MiKumBa21/Wetterstation/Dokumentation/Administratorhandbuch.docx

HTL-Wels

ITP

Administratorhandbuch

Wetterstation

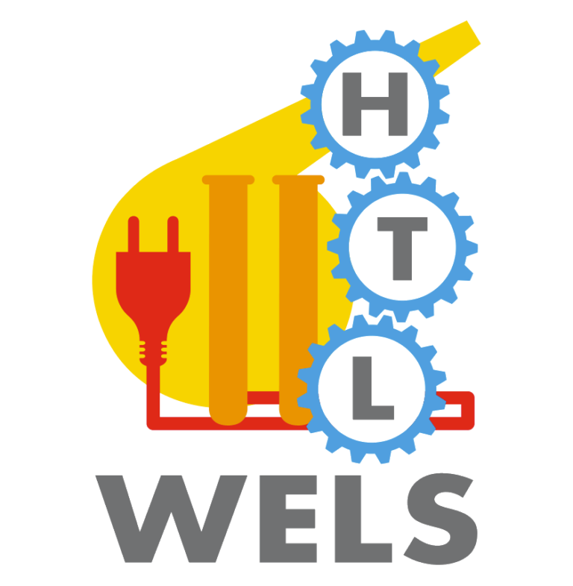
[picture p1: figure]
Höhere technische Bundeslehranstalt Wels

# 1. Ziel des Administratorhandbuchs

Dieses Dokument beschreibt die vollständige Installation, Inbetriebnahme und Erweiterung der Wetterstation.

Die Beschreibung richtet sich vorallem an Personen ohne tiefgehende IT-Kenntnisse. Alle Arbeitsschritte werden deshalb möglichst einfach und verständlich erklärt.

Ziel ist es, dass auch neue Mitarbeiterinnen und Mitarbeiter die Wetterstation selbstständig installieren, starten und bedienen können.

# 2. Benötigte Hardware

Bevor mit dem Aufbau begonnen wird, müssen alle Komponenten vorhanden sein. Die folgende Liste enthält alles, was für einen vollständigen Aufbau der Wetterstation benötigt wird.

## 2.1 Elektronik & Hauptkomponenten

Komponente | Beschreibung | Hinweis
Raspberry Pi Zero 2W | Der Hauptrechner der Wetterstation – verarbeitet alle Sensordaten, speichert sie in der Datenbank und stellt die Website bereit | Unbedingt die Version 2W verwenden (hat WLAN eingebaut)
MicroSD-Karte | Speichermedium für das Betriebssystem und die gesamte Software | Mindestens 16 GB, empfohlen 32 GB
MicroSD-Kartenleser | Wird einmalig zum Aufspielen des Images benötigt | Viele Laptops haben einen eingebauten Leser; sonst USB-Adapter
DHT22 | Sensor für Temperatur (–40 bis +80 °C) und relative Luftfeuchtigkeit (0–100 %) | Oft als Breakout-Board mit 3 Pins erhältlich – das ist die einfachere Variante
VEML7700 | Sensor für Lichtstärke | Als Breakout-Board kaufen (z. B. von Adafruit) – hat bereits die nötigen Widerstände eingebaut
US5881LUA | Hall-Effekt-Sensor; erkennt Magnetfelder und wird im selbstgebauten Anemometer zur Messung der Windgeschwindigkeit verwendet | Kleiner 3-poliger Sensor im TO-92-Gehäuse (sieht aus wie ein kleiner Transistor)
Magnet (Neodym, klein) | Wird im Windrad des Anemometers befestigt und löst beim Vorbeidrehen den Hall-Sensor aus | Muss stark genug sein, um den Hall-Sensor zuverlässig zu aktivieren

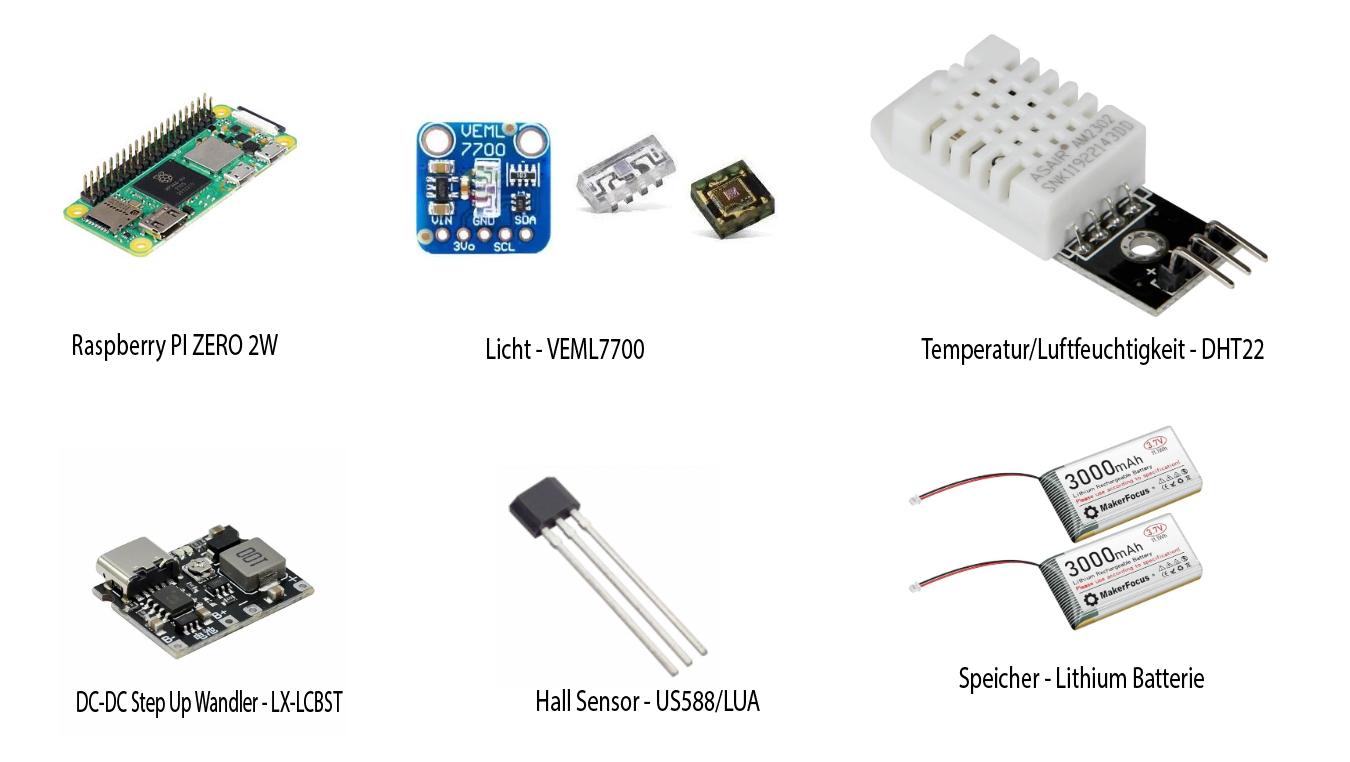
[picture p2: figure]

## 2.2 Stromversorgung

Material | Beschreibung | Hinweis
Akku (LiFePO4) | Versorgt den Raspberry Pi und die Sensoren mit Strom | 3000mAh empfohlen
DC-DC-Wandler | Wandelt die Akkuspannung auf die für den Raspberry Pi benötigte Spannung um | Einstellbar auf 5V; Ausgangsspannung vor dem Anschluss unbedingt messen

## 2.3 Kabel & Verbindungsmaterial

Material | Beschreibung | Hinweis
Jumperkabel | Verbindungskabel zwischen Sensoren und GPIO-Pins des Raspberry Pi | Farben: egal
Lötkolben + Lötzinn | Für feste, dauerhafte Verbindungen der Kabel an die Sensor-Pins | Alternativ: Steckverbinder, aber Löten ist langlebiger für den Außeneinsatz
Schrumpfschlauch | Isoliert gelötete Verbindungen | mit Heißluftfön oder Feuerzeug aufschrumpfen
Kabelbinder | Kabel im Gehäuse ordentlich fixieren | Klein (2,5 mm Breite) reicht aus

## 2.4 Werkzeug

Werkzeug | Wofür
Multimeter | Spannungen messen, Kabelverbindungen prüfen, Kurzschlüsse ausschließen
Seitenschneider / Abisolierer | Kabel kürzen und abisolieren
Kleiner Imbud Schraubendreher | Gehäuse montieren
Heißklebepistole | Sensoren im Gehäuse fixieren (wenn keine Halterungen vorgesehen sind)
3D-Drucker (oder Zugang dazu) | Für das Gehäuse und das Anemometer (siehe Abschnitt 2.5)

## 2.5 Gehäuse & 3D-Druck

Das Gehäuse der Wetterstation sowie das Anemometer (Windrad) wurden eigens für dieses Projekt konstruiert und mit einem 3D-Drucker aus PETG-Filament gedruckt. PETG ist wetter- und UV-beständiger als das häufiger verwendete PLA und daher für den Außeneinsatz besser geeignet.

CAD-Dateien: Die CAD-Dateien für das Gehäuse und das Anemometer befinden sich im GitHub-Repository des Projekts. Sie können mit Tinkercad (kostenlos, browserbasiert, auch für Einsteiger geeignet) oder jedem anderen CAD-Programm geöffnet und angepasst werden.

[Screenshot-Platzhalter: Screenshot der CAD-Dateien im GitHub-Repository]

Gehäuse anpassen – worauf zu achten ist:

Bevor das Gehäuse gedruckt wird, sollte geprüft werden, ob alle Komponenten hineinpassen. Folgende Maße sind relevant:

- Raspberry Pi Zero 2W: 65 × 30 mm Grundfläche, ca. 5 mm hoch (ohne Pins)
- DHT22 (Breakout): ca. 15 × 25 mm
- VEML7700 (Breakout): ca. 19 × 13 mm
- Hall-Sensor: TO-92-Gehäuse, ca. 5 × 5 mm – muss im Anemometer so sitzen, dass der Magnet im Windrad direkt daran vorbeizieht (Abstand: max. 3–5 mm)
- Kabelkanäle und Kabeldurchführungen einplanen
- Lüftungsschlitze für den Raspberry Pi vorsehen – er erzeugt im Betrieb Wärme
- Der DHT22 muss Luftkontakt haben (nicht vollständig einschließen), darf aber nicht direktem Regen ausgesetzt sein → Wetterschutzblende oder seitliche Öffnung

Anemometer:

Das Anemometer besteht aus einem Rotor mit befestigtem Neodym-Magneten und einer fixen Halterung für den Hall-Sensor. Bei jeder vollen Umdrehung des Windrades fährt der Magnet am Hall-Sensor vorbei – das erzeugt einen elektrischen Impuls, der vom Raspberry Pi gezählt wird. Aus der Anzahl der Impulse pro Zeiteinheit wird die Windgeschwindigkeit berechnet.

[Screenshot-Platzhalter: Foto des fertig gedruckten Anemometers mit eingebautem Magneten und Hall-Sensor]

Druckempfehlungen:

Einstellung | Empfehlung
Material | PETG (für Außeneinsatz); kein PLA
Schichthöhe | 0,2 mm
Wandstärke | Mindestens 3 Perimeter (ca. 1,2 mm bei 0,4er Düse)
Füllung (Infill) | 20–30 %
Supports | Abhängig vom Modell
Druckbett-Temperatur | ~70–80 °C (PETG haftet besser mit beheiztem Bett)
Düsentemperatur | ~230–245 °C

Tipp: Vor dem vollständigen Druck immer zuerst einen kleinen Testdruck (z. B. nur eine Ecke des Gehäuses) machen, um die Maße und die Passgenauigkeit zu prüfen. Das spart Filament und Zeit.

# 3. Verkabelung der Sensoren

Wichtig: Den Raspberry Pi immer ausschalten (Strom trennen), bevor Sensoren angeschlossen oder getrennt werden. Niemals Kabel unter Spannung anschließen!

## 3.1 Pinbelegung

Der Raspberry Pi Zero 2W hat einen 40-poligen GPIO-Stecker. Die Pins sind in zwei Reihen angeordnet und von 1 bis 40 nummeriert. Pins, die für mehrere Sensoren benötigt werden, wie zum Beispiel der Ground oder der 3,3V Pin, können über Klemmen auf eins zusammengeführt werden. Für diese Wetterstation werden nur folgende Pins verwendet:

Pin-Nummer | Bezeichnung | Verwendung
Pin 1 | 3,3 V (Stromversorgung) | Strom für alle drei Sensoren
Pin 2 | 5 V (STromversorgung) | Strom vom Akku
Pin 3 | GPIO2 - SDA | Daten (VEML7700)
Pin 5 | GPIO3 - SCL | Takt (VEML7700)
Pin 6 | GND (Masse) | Masse für alle drei Sensoren
Pin 7 | GPIO4 | Datensignal DHT22
Pin 11 | GPIO17 | Datensignal Hall-Sensor (Windgeschwindigkeit)

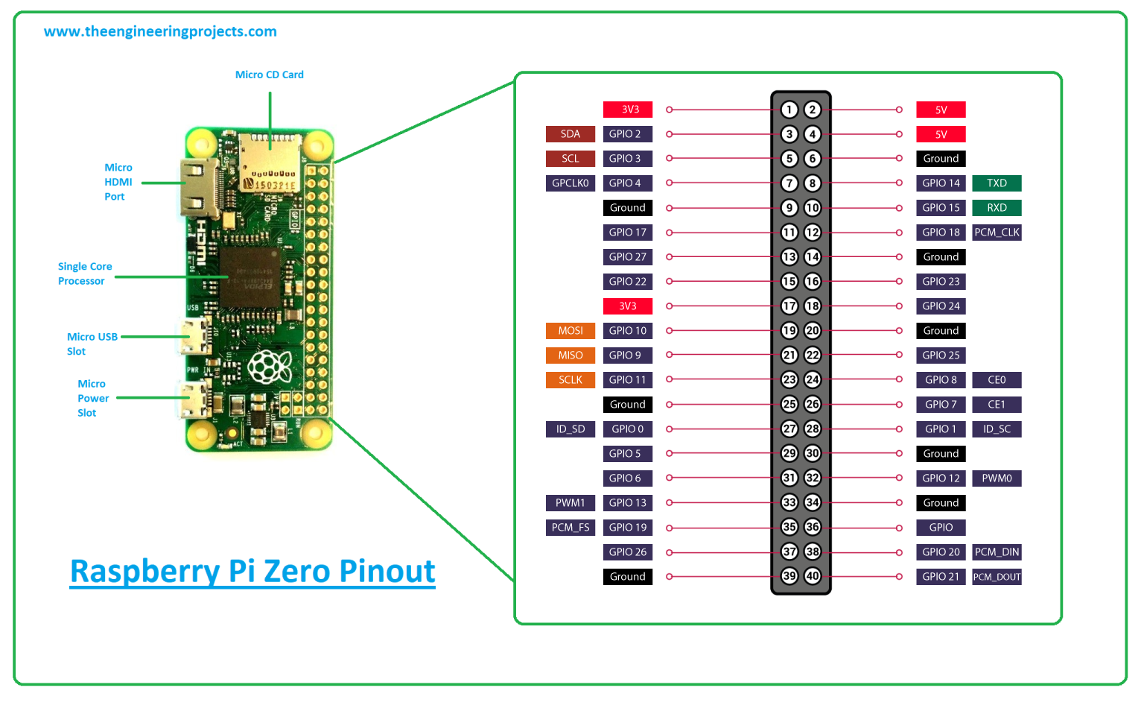
[picture p3: figure]

Die Abbildung zeigt die genaue Belegung der Anschlüsse.

## 3.2 VEML7700 – Umgebungslicht / UV

Der VEML7700 kommuniziert über den sogenannten I²C-Bus – das ist ein einfaches 2-Draht-Kommunikationsprotokoll. Er benötigt insgesamt 4 Kabelverbindungen.

Verbindungsübersicht:

Sensor-Anschluss | Kabelfarbe (empfohlen) | Raspberry Pi
VIN (Stromversorgung) | Rot | Pin 1 – 3,3 V
GND (Masse) | Schwarz | Pin 9 – GND
SDA (Datenkabel) | Blau | Pin 3 – GPIO2 - SDA
SCL (Taktkabel) | Blau | Pin 5 – GPIO3 - SCL

Schritt-für-Schritt:

1. Raspberry Pi ausschalten – Strom komplett trennen
2. VEML7700-Sensor bereitlegen
3. Rotes Kabel: VIN am Sensor → Pin 1 am Raspberry Pi (3,3 V)
4. Schwarzes Kabel: GND am Sensor → Pin 9 am Raspberry Pi (GND)
5. Blaues Kabel: SDA am Sensor → Pin 3 am Raspberry Pi (GPIO2 - SDA)
6. Blaues Kabel: SCL am Sensor → Pin 5 am Raspberry Pi (GPIO3 - SCL)
7. Alle Verbindungen auf festen Sitz prüfen – kein Kabel darf wackeln

[Screenshot-Platzhalter: Foto VEML7700 angeschlossen am Raspberry Pi]

## 3.3 DHT22 – Temperatur & Luftfeuchtigkeit

Der DHT22 hat 3 Anschlüsse (manche Varianten haben 4 Pins, wobei einer nicht belegt ist – das ist normal).

Verbindungsübersicht:

Sensor-Anschluss | Kabelfarbe (empfohlen) | Raspberry Pi
VCC (Stromversorgung) | Rot | Pin 1 – 3,3 V
DATA (Datenkabel) | Grün | Pin 7 – GPIO4
GND (Masse) | Schwarz | Pin 9 – GND

Schritt-für-Schritt:

1. Raspberry Pi ausschalten – Strom komplett trennen
2. DHT22-Sensor bereitlegen
3. Rotes Kabel: VCC am Sensor → Pin 1 am Raspberry Pi (3,3 V)
4. Grünes Kabel: DATA am Sensor → Pin 7 am Raspberry Pi (GPIO4)
5. Schwarzes Kabel: GND am Sensor → Pin 9 am Raspberry Pi (GND)
6. Alle Verbindungen auf festen Sitz prüfen

Hinweis: Darauf achten, dass VCC und GND nicht vertauscht werden – das kann den Sensor beschädigen!

[Screenshot-Platzhalter: Foto DHT22 angeschlossen am Raspberry Pi]

## 3.4 Hall-Sensor (US5881LUA) – Windgeschwindigkeit

Der Hall-Sensor erkennt magnetische Felder und wird im selbstgebauten Anemometer eingesetzt, um die Umdrehungen des Windrades zu messen. Er hat 3 Anschlüsse.

Verbindungsübersicht:

Sensor-Anschluss | Kabelfarbe (empfohlen) | Raspberry Pi
VCC (Stromversorgung) | Rot | Pin 1 – 3,3 V
OUT (Ausgangssignal) | Grün | Pin 11 – GPIO17
GND (Masse) | Schwarz | Pin 9 – GND

Schritt-für-Schritt:

1. Raspberry Pi ausschalten – Strom komplett trennen
2. Hall-Sensor bereitlegen
3. Rotes Kabel: VCC am Sensor → Pin 1 am Raspberry Pi (3,3 V)
4. Grünes Kabel: OUT am Sensor → Pin 11 am Raspberry Pi (GPIO17)
5. Schwarzes Kabel: GND am Sensor → Pin 9 am Raspberry Pi (GND)
6. Alle Verbindungen auf festen Sitz prüfen
7. Prüfen, ob der Sensor korrekt im Anemometer-Gehäuse sitzt und der Magnet am Windrad am Sensor vorbeiläuft

[Screenshot-Platzhalter: Foto Hall-Sensor im Anemometer-Gehäuse]

## 3.5 Gesamtübersicht aller Verbindungen

Wenn alle drei Sensoren angeschlossen sind, teilen sich VCC und GND jeweils denselben Pin am Raspberry Pi. Das ist korrekt und gewollt – mehrere Kabel an einem Pin sind über einen Verteiler (z. B. Breadboard oder Lüsterklemme) möglich.

[Screenshot-Platzhalter: Schaltplan-Diagramm mit allen drei Sensoren]

Abschlusskontrolle vor dem Einschalten:

- VEML7700: VIN → Pin 1, GND → Pin 9, SDA → Pin 3, SCL → Pin 5
- DHT22: VCC → Pin 1, DATA → Pin 7, GND → Pin 9
- Hall-Sensor: VCC → Pin 1, OUT → Pin 11, GND → Pin 9
- Kein Kabel wackelt oder ist lose
- VCC und GND nirgends vertauscht

# 4. Stromversorgung

Die Wetterstation wird auf folgende Art angeschlossen:

[Screenshot-Platzhalter: Schaltplan Stromversorgung]

Checkliste vor dem ersten Einschalten:

- Alle Sensoren angeschlossen
- Alle Kabelverbindungen geprüft
- Akku geladen (bei Solarbetrieb)
- Sicherungen eingesetzt
- Raspberry Pi korrekt montiert

Erst wenn alle Punkte erfüllt sind, die Stromversorgung einschalten.

## 5. Image auf SD-Karte aufspielen

Das fertige System-Image liegt im GitHub-Repository des Projekts und muss einmalig auf die SD-Karte gespielt werden. Das Image enthält bereits das Betriebssystem, alle Software-Komponenten und die Wetterstation-Anwendung – es sind keine weiteren Installationsschritte notwendig.

Schritt 1: Image herunterladen

1. Öffne einen Webbrowser und rufe das GitHub-Repository der Wetterstation auf
2. Navigiere zum Bereich Releases oder direkt zur Image-Datei
3. Lade die Datei herunter (Dateiendung .img oder .img.gz)

[Screenshot-Platzhalter: GitHub-Seite mit dem Image-Download]

Schritt 2: Raspberry Pi Imager installieren

1. Öffne die Website: https://www.raspberrypi.com/software/
2. Lade den Raspberry Pi Imager für dein Betriebssystem (Windows / macOS / Linux) herunter
3. Installiere das Programm

[Screenshot-Platzhalter: Download-Seite Raspberry Pi Imager]

Schritt 3: SD-Karte bespielen

1. Stecke die SD-Karte (mindestens 16 GB) in den SD-Kartenleser deines Computers
2. Starte den Raspberry Pi Imager
3. Wähler den Raspberry Pi Zero 2W aus und klicke auf „Weiter“

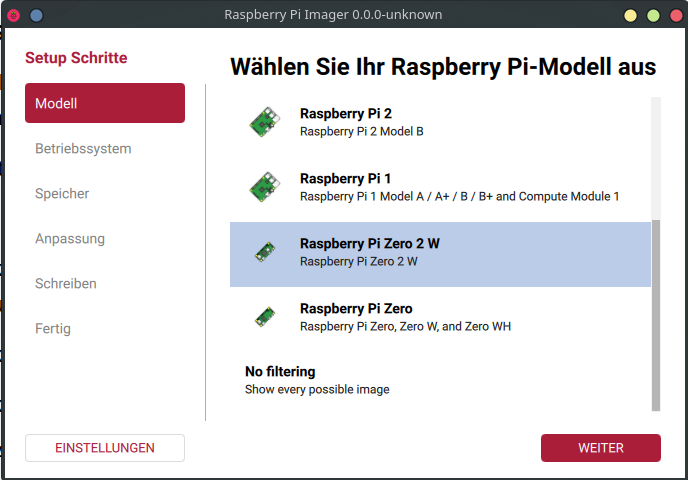
[picture p4: figure]

4. Klicke auf „OS wählen" → ganz unten „Eigenes Image" → die heruntergeladene wetterstation.img-Datei auswählen

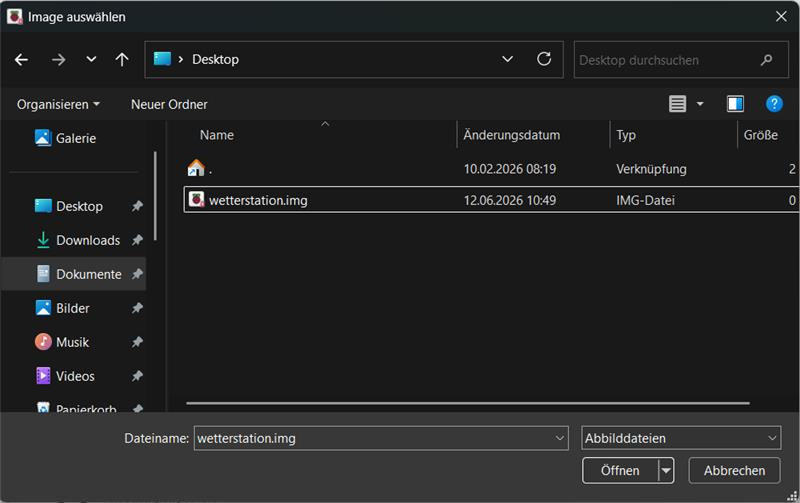
[picture p5: figure]

5. Klicke auf „SD-Karte wählen" → die eingelegte SD-Karte auswählen
6. Klicke auf „Weiter" und bestätige mit „Ja"

Achtung: Alle Daten auf der SD-Karte werden dabei gelöscht!

6. Warten bis der Vorgang abgeschlossen ist (kann einige Minuten dauern)
7. SD-Karte sicher auswerfen

Schritt 4: SD-Karte einsetzen

1. Raspberry Pi ausschalten (Strom trennen, falls bereits angeschlossen)
2. SD-Karte in den SD-Kartenslot des Raspberry Pi einsetzen (einrasten bis es „klickt")
3. Strom wieder anschließen

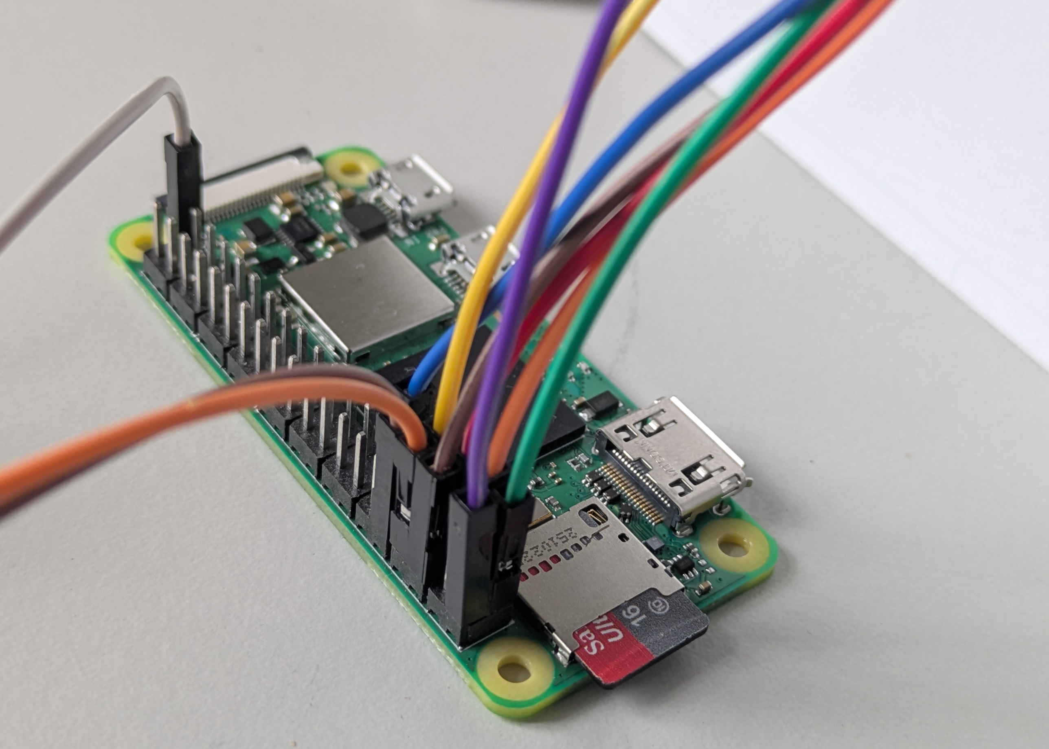
[picture p6: figure]

## 6. Erster Start & WLAN-Einrichtung

Erster Start

Nach dem Einschalten startet das System automatisch. Der erste Start kann 3–4 Minuten dauern. Es ist kein Bildschirm notwendig.

WLAN einrichten

Damit die Website der Wetterstation im Heimnetzwerk erreichbar ist, muss die WLAN-Verbindung eingerichtet werden.

Vorgehensweise:

1. Verbinde deinen Computer oder dein Smartphone mit dem von der Wetterstation erstelltem WLAN „Wetterstation-Setup“
2. Rufe die Website der Wetterstation im Browser auf (Im Wetterstation-Setup WLAN unter 10.42.0.1)
3. Öffne die Einstellungen (⚙ unten rechts)
4. Wähle den Abschnitt „WLAN-Verwaltung"

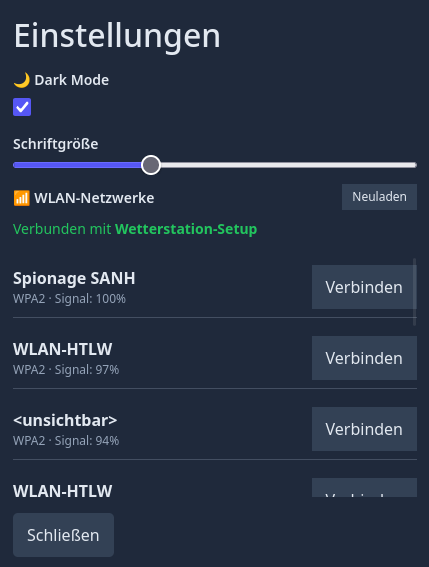
[picture p7: figure]

5. Wähle das gewünschte Netzwerk aus der Liste aus
6. Gib das WLAN-Passwort ein
7. Klicke auf „Verbinden"

Nach erfolgreicher Verbindung wird das Netzwerk gespeichert und beim nächsten Start automatisch verwendet.

## 7. Website aufrufen

Sobald die Wetterstation gestartet und mit dem Heimnetzwerk verbunden ist, kann die Website über jeden Browser im selben Netzwerk aufgerufen werden. Die Adresse setzt sich aus der IP-Adresse des Raspberry Pi zusammen – diese lässt sich über den Router ermitteln.

Tipp: Es empfiehlt sich, im Router eine feste IP-Adresse für den Raspberry Pi zu vergeben (DHCP-Reservierung), damit sich die Adresse nach einem Router-Neustart nicht ändert.

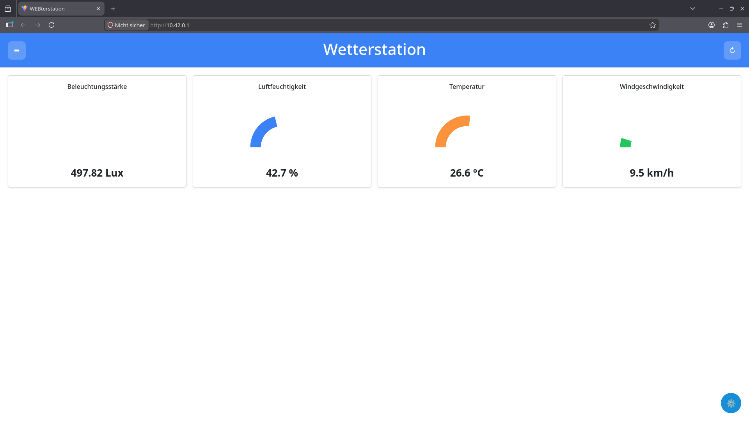
[picture p8: figure]

# 8. System überprüfen

Nach der Inbetriebnahme sollte geprüft werden, ob alles korrekt funktioniert:

- Dashboard lädt im Browser
- Alle Sensoren zeigen Messwerte an (keine leeren Kacheln)
- Diagramme werden geladen
- WLAN-Status in den Einstellungen zeigt „verbunden"

Falls einzelne Sensoren keine Werte liefern → Verkabelung prüfen (Abschnitt 3) oder Gerät neu starten.

## 9. Erweiterung um neue Sensoren

Das System wurde so entwickelt, dass neue Sensoren nachgerüstet werden können.

Vorgehensweise:

1. Sensor physisch anschließen (Abschnitt 3 beachten)
2. SSH-Zugang zum Raspberry Pi herstellen (Terminal auf dem eigenen Computer öffnen):

ssh admin@[IP-Adresse]

3. Datenbankeintrag für den neuen Sensor anlegen (Datei database/scripts/init_db.py bearbeiten):
  - Neuen Sensor in der sensor-Tabelle eintragen
  - Neuen Datentyp in der dataTyp-Tabelle eintragen
4. Sensor-Auslesecode im Backend ergänzen
5. Wetterstation-Service neu starten:

sudo systemctl restart wetterstation

6. Website neu laden – der neue Sensor erscheint automatisch im Dashboard

## 10. Wartung

Empfohlener Wartungsrhythmus: einmal pro Monat

Aufgabe | Beschreibung
Sensorfunktion prüfen | Dashboard aufrufen, alle Kacheln auf Werte prüfen
Netzwerkverbindung | WLAN-Status in den Einstellungen kontrollieren
Speicherplatz | Per SSH: df -h eingeben, freien Speicher prüfen
Datenbankgröße | Datei database/WetterstationData.db auf Größe prüfen
Stromversorgung | Akku-Ladezustand (bei Solarbetrieb), Kabel auf Schäden
Physische Kontrolle | Gehäuse, Sensoren und Kabel auf Schäden oder Verschmutzung

Neustart des Systems (bei Problemen oder nach Updates):

sudo reboot

Oder Strom kurz trennen und wieder anschließen.

# 11. Fehlerbehebung

Website nicht erreichbar

Checkliste:

- ☐ Raspberry Pi eingeschaltet?
- ☐ Stromversorgung OK?
- ☐ Gerät im selben Netzwerk wie die Wetterstation?
- ☐ Richtige IP-Adresse eingegeben?
- ☐ Backend-Service läuft?

SSH-Zugang herstellen und Service-Status prüfen:

sudo systemctl status wetterstation

Falls der Service gestoppt ist:

sudo systemctl start wetterstation

[Screenshot-Platzhalter: Terminal mit systemctl status-Ausgabe]

Keine Sensordaten sichtbar

- Sensorverkabelung prüfen (Abschnitt 3)
- Backend-Service neu starten (siehe oben)
- Log-Dateien prüfen:

cat /home/admin/Wetterstation/logs/Wetterstation.log

WLAN-Netzwerke werden nicht angezeigt

- Raspberry Pi neu starten
- Prüfen, ob der WLAN-Adapter erkannt wird:

ip link show wlan0

- Falls kein wlan0 vorhanden: Adapter/Hardware prüfen

Diagramme bleiben leer

- Abwarten – kurz nach dem Start sind noch keine Daten vorhanden
- Kürzeren Zeitraum auswählen (z. B. „Heute")
- Datenbankstatus prüfen:

ls -lh /home/admin/Wetterstation/database/WetterstationData.db

# 12. Backup und Wiederherstellung

Datenbank sichern

Die Messwerte sind in der Datei WetterstationData.db gespeichert. Diese Datei sollte regelmäßig gesichert werden.

Backup manuell erstellen (per SSH):

cp /home/admin/Wetterstation/database/WetterstationData.db \

/home/admin/backup_$(date +%Y%m%d).db

Die Backup-Datei kann anschließend auf einen USB-Stick oder Netzwerkspeicher kopiert werden.

Vollständiges System-Backup

Das vollständige System kann als Image gesichert werden (funktioniert am besten, wenn der Raspberry Pi ausgeschaltet ist – SD-Karte mit einem anderen Computer auslesen und mit dem Raspberry Pi Imager sichern).

Wiederherstellung

Für eine vollständige Wiederherstellung:

1. Neues Image von GitHub herunterladen (Abschnitt 5)
2. Image auf SD-Karte aufspielen
3. Datenbank-Backup zurückspielen:

cp /pfad/zum/backup.db /home/admin/Wetterstation/database/WetterstationData.db

4. Wetterstation neu starten
