MiKumBa21/Wetterstation/Vorbereitung/Brainstorming/Neue Ziele.docx

# MUSS-Ziele

- Sensoren
  - Temperatursensor
  - Hygrosensor
  - Beleuchtungssensor
  - UV-Index
- Gehäuse

# KANN-Ziele

- Windrad (3D-Druck)

# NICHT-Ziele
