MiKumBa21/Wetterstation/Vorbereitung/Time Planning/Time_Planning_Chart.pdf

1 | Software installation | 2 tage? | 12.01.26, 08:00 | 13.01.26, 17:00 | | Aistleitner;Bergbauer;Brückl
2 | Raspberry activation | 12 tage? | 12.01.26, 08:00 | 27.01.26, 17:00 | | Bergbauer;Brückl
3 | Sensor implementation | 4 tage? | 28.01.26, 08:00 | 02.02.26, 17:00 | 2 | Bergbauer;Brückl
4 | Finished readble sensors | 0 tage? | 02.02.26, 17:00 | 02.02.26, 17:00 | 3 | Bergbauer;Brückl
5 | Case Modeling | 18 tage? | 01.03.26, 08:00 | 25.03.26, 17:00 | 4 | Bergbauer;Brückl
6 | Think about an Anemometer | 5 tage? | 26.03.26, 08:00 | 01.04.26, 17:00 | 5 | Bergbauer;Brückl
7 | Build the Anemometer | 9 tage? | 02.04.26, 08:00 | 14.04.26, 17:00 | 6
8 | Combine the Anemomter and the Case | 5 tage? | 15.04.26, 08:00 | 21.04.26, 17:00 | 7 | Bergbauer;Brückl
9 | Finished Case and power supply | 0 tage? | 30.03.26, 07:00 | 30.03.26, 08:00 | 5 | Bergbauer;Brückl
10 | Framework for Web UI | 10 tage? | 11.02.26, 08:00 | 24.02.26, 17:00 | | Aistleitner
11 | Web UI with not yet functional features | 15 tage? | 25.02.26, 08:00 | 17.03.26, 17:00 | 10 | Aistleitner
12 | Finished Web UI Foundations | 0 tage | 17.03.26, 17:00 | 17.03.26, 17:00 | 11 | Aistleitner
13 | Functionalities in Web UI | 12 tage? | 18.03.26, 08:00 | 02.04.26, 17:00 | 11;17 | Aistleitner;Brückl
14 | Design | 12 tage? | 03.04.26, 08:00 | 20.04.26, 17:00 | 13 | Aistleitner
15 | Finished Frontend | 0 tage | 20.04.26, 17:00 | 20.04.26, 17:00 | 14 | Aistleitner;Brückl
16 | Setup a Database | 15 tage? | 03.02.26, 08:00 | 23.02.26, 17:00 | 4AA | Brückl
17 | Creating APIs | 15 tage? | 24.02.26, 08:00 | 16.03.26, 17:00 | 16 | Brückl
18 | Finished Database&APIs | 0 tage | 16.03.26, 17:00 | 16.03.26, 17:00 | 17 | Brückl
19 | Create Web Server | 12 tage? | 21.04.26, 08:00 | 06.05.26, 17:00 | 15;18 | Brückl
20 | Finished Web Server | 0 tage | 06.05.26, 17:00 | 06.05.26, 17:00 | 19 | Brückl
21 | setup mDNS | 12 tage | 07.05.26, 08:00 | 22.05.26, 17:00 | 20 | Brückl
22 | Finished Project | 0 tage | 10.06.26, 07:00 | 10.06.26, 08:00 | 9;21 | Aistleitner;Bergbauer;Brückl
Name | Dauer | Start | Ende | Vorgänger | Ressourcen
- Seite1

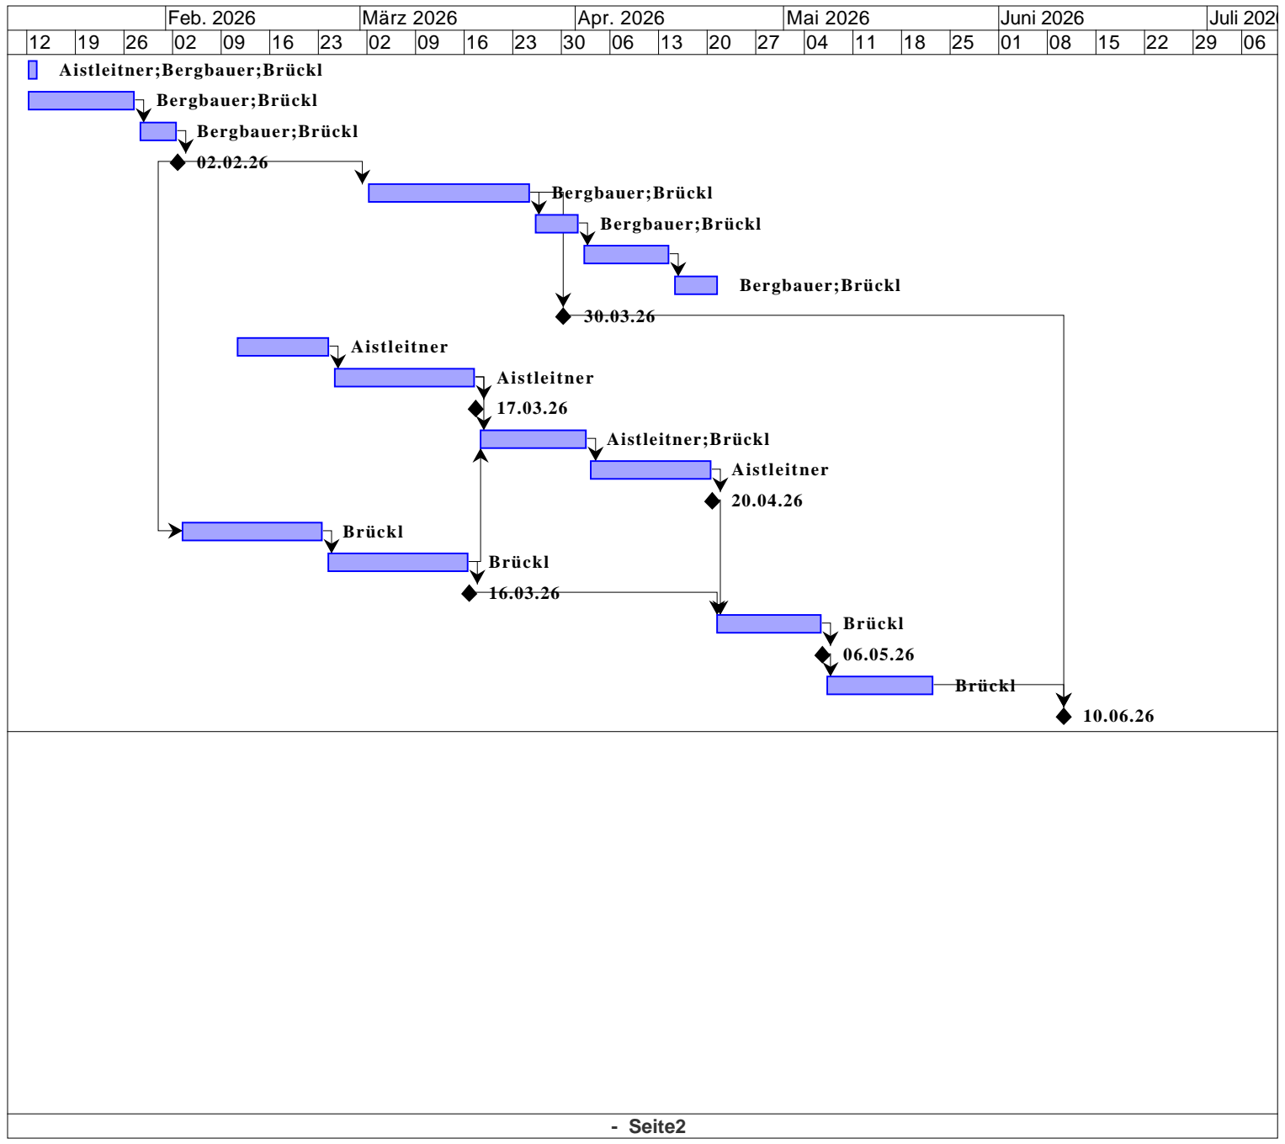
[picture p18: figure]
Feb. 2026; März 2026; Apr. 2026; Mai 2026; Juni 2026; Juli 2026; Aistleitner;Bergbauer;Brückl; Bergbauer;Brückl; Aistleitner; Aistleitner;Brückl; Brückl; - Seite2
