MiKumBa21/Wetterstation/Vorbereitung/Time Planning/TimeTable.pdf

1 | Software installation | 2 tage? | 12.01.26, 08:00 | 13.01.26, 17:00 | | Aistleitner;Bergbauer;Brückl
2 | Raspberry activation | 12 tage? | 12.01.26, 08:00 | 27.01.26, 17:00 | | Bergbauer;Brückl
3 | Sensor implementation | 4 tage? | 28.01.26, 08:00 | 02.02.26, 17:00 | 2 | Bergbauer;Brückl
4 | Finished readble sensors | 0 tage? | 02.02.26, 17:00 | 02.02.26, 17:00 | 3 | Bergbauer;Brückl
5 | Work out energy independent power sup... | 19 tage? | 03.02.26, 08:00 | 27.02.26, 17:00 | 4 | Bergbauer;Brückl
6 | Case Modeling | 18 tage? | 02.03.26, 08:00 | 25.03.26, 17:00 | 5 | Bergbauer;Brückl
7 | Finished Case and power supply | 0 tage? | 30.03.26, 07:00 | 30.03.26, 08:00 | 6 | Bergbauer;Brückl
8 | Framework for Web UI | 10 tage? | 11.02.26, 08:00 | 24.02.26, 17:00 | | Aistleitner
9 | Web UI with not yet functional features | 15 tage? | 25.02.26, 08:00 | 17.03.26, 17:00 | 8 | Aistleitner
10 | Finished Web UI Foundations | 0 tage | 17.03.26, 17:00 | 17.03.26, 17:00 | 9 | Aistleitner
11 | Functionalities in Web UI | 12 tage? | 18.03.26, 08:00 | 02.04.26, 17:00 | 9;15 | Aistleitner;Brückl
12 | Design | 12 tage? | 03.04.26, 08:00 | 20.04.26, 17:00 | 11 | Aistleitner
13 | Finished Frontend | 0 tage | 20.04.26, 17:00 | 20.04.26, 17:00 | 12 | Aistleitner;Brückl
14 | Setup a Database | 15 tage? | 03.02.26, 08:00 | 23.02.26, 17:00 | 4AA | Brückl
15 | Creating APIs | 15 tage? | 24.02.26, 08:00 | 16.03.26, 17:00 | 14 | Brückl
16 | Finished Database&APIs | 0 tage | 16.03.26, 17:00 | 16.03.26, 17:00 | 15 | Brückl
17 | Create Web Server | 12 tage? | 21.04.26, 08:00 | 06.05.26, 17:00 | 13;16 | Brückl
18 | Finished Web Server | 0 tage | 06.05.26, 17:00 | 06.05.26, 17:00 | 17 | Brückl
19 | setup mDNS | 12 tage | 07.05.26, 08:00 | 22.05.26, 17:00 | 18 | Brückl
20 | Finished Project | 0 tage | 10.06.26, 07:00 | 10.06.26, 08:00 | 7;19 | Aistleitner;Bergbauer;Brückl
Name | Dauer | Start | Ende | Vorgänger | Ressourcen
- Seite1

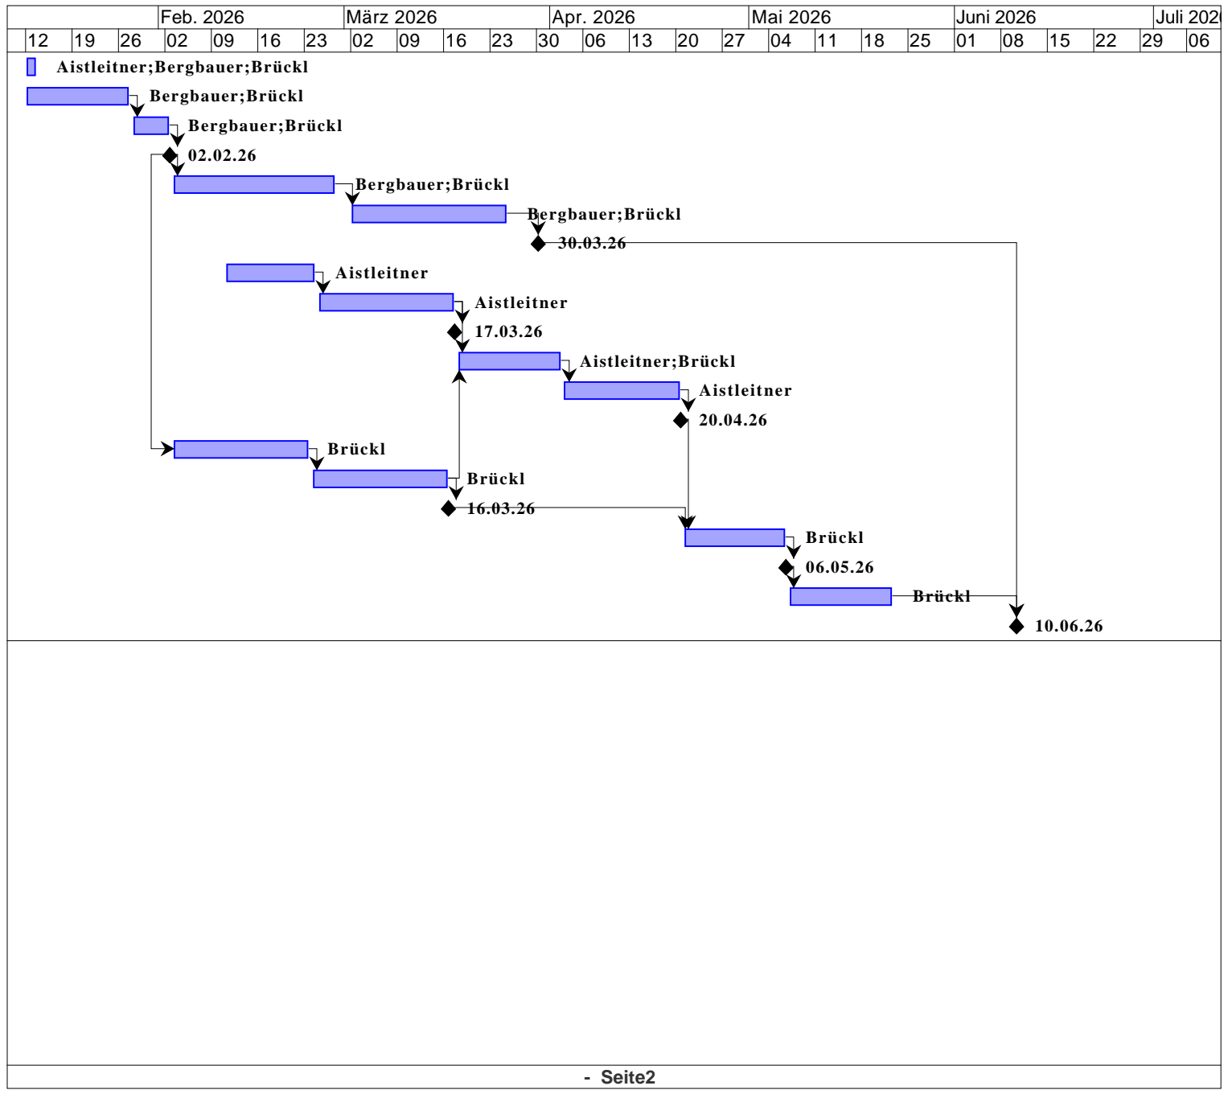
[picture p19: figure]
Feb. 2026; März 2026; Apr. 2026; Mai 2026; Juni 2026; Juli 2026; Aistleitner;Bergbauer;Brückl; Bergbauer;Brückl; Aistleitner; Aistleitner;Brückl; Brückl; - Seite2
