MiKumBa21/Wetterstation/Vorbereitung/Pflichtenheft/Fragen an Loidl.docx

Fragt diese Frage Loidl oder fragt vorhermal Thomas und überarbeitet es passend zu den Antworten!

1. Im Dokument Pflichtenheft_Zusammenfassung steht bei Einleitung „Neben der expliziten Benennung des Auftragnehmers und des Auftraggebers sollte an …“. Wie sollen wir als Auftragnehmer angegeben werden? Eine fiktionale Firma oder der Projektmanager hinschreiben?

HTL-Wels

2. Was ist mit „Interfaces“ bei 2.5 genau gemeint?

Schnittstelle zu anderen Projekten

3. Was ist bei 6.2 genau gemeint?
4. Keine Frage aber trotzdem zum machen: 5.1 und 5.2 ausfüllen

Is gemacht

Allgemein Thomas fragen, ob er drüber schauen kann.
