MiKumBa21/Wetterstation/Dokumentation/Bild1.png

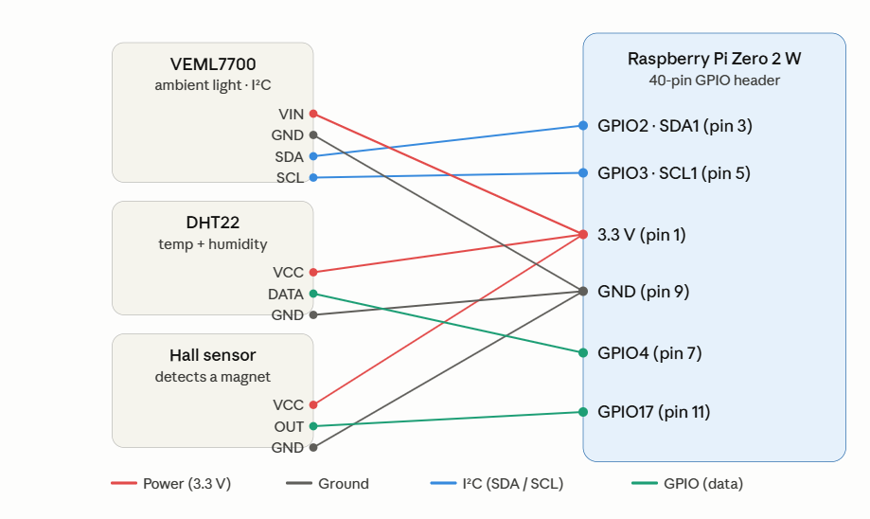
Dokumentation/Bild1.png
