MiKumBa21/Wetterstation/Dokumentation/Bild.png

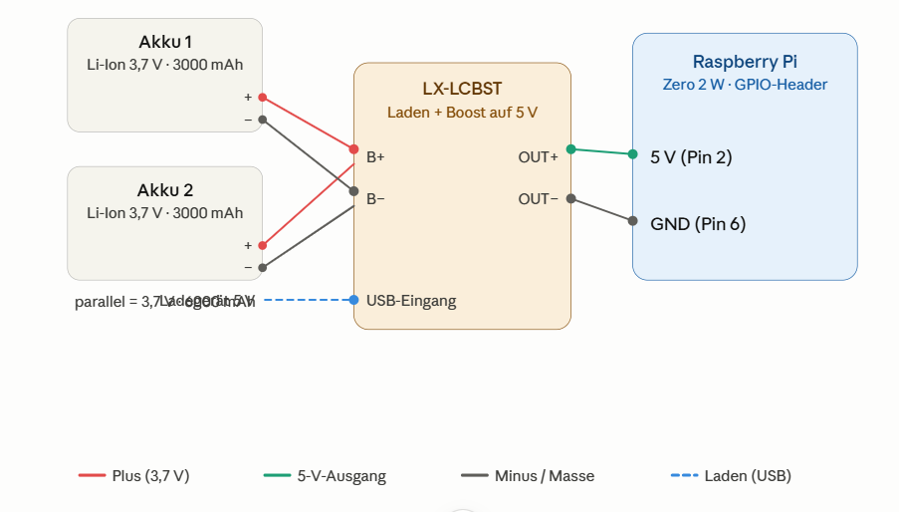
Dokumentation/Bild.png
