MiKumBa21/Wetterstation/Vorbereitung/Project Handbook/Blank diagram (1).png

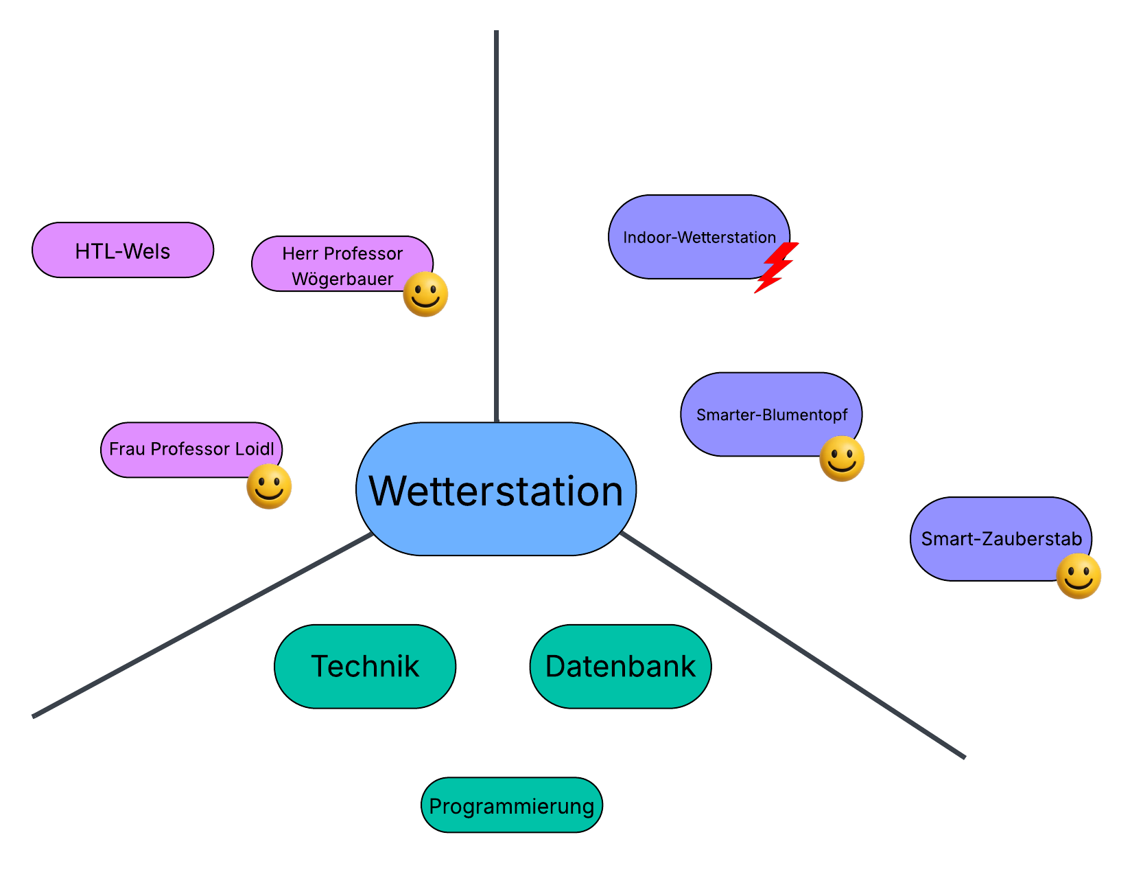
Vorbereitung/Project Handbook/Blank diagram (1).png
