MiKumBa21/Wetterstation/Vorbereitung/Project Handbook/Breakdown structure.png

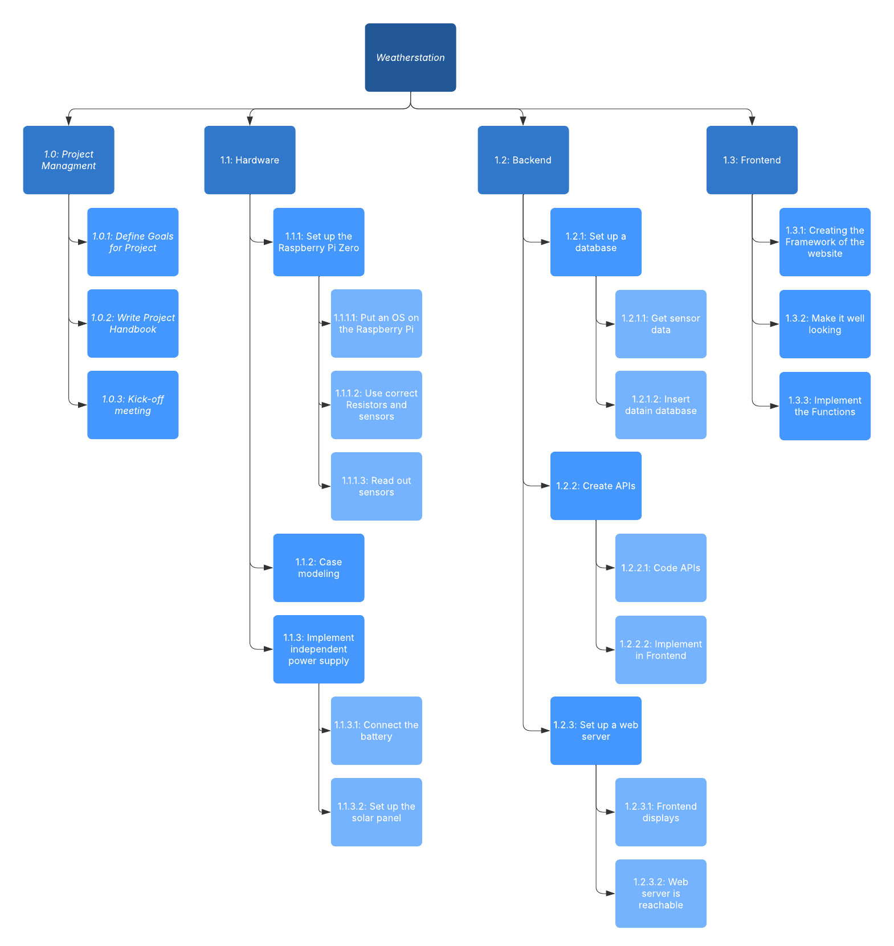
Vorbereitung/Project Handbook/Breakdown structure.png
