MiKumBa21/Wetterstation/Vorbereitung/Project Handbook/Flowchart.png

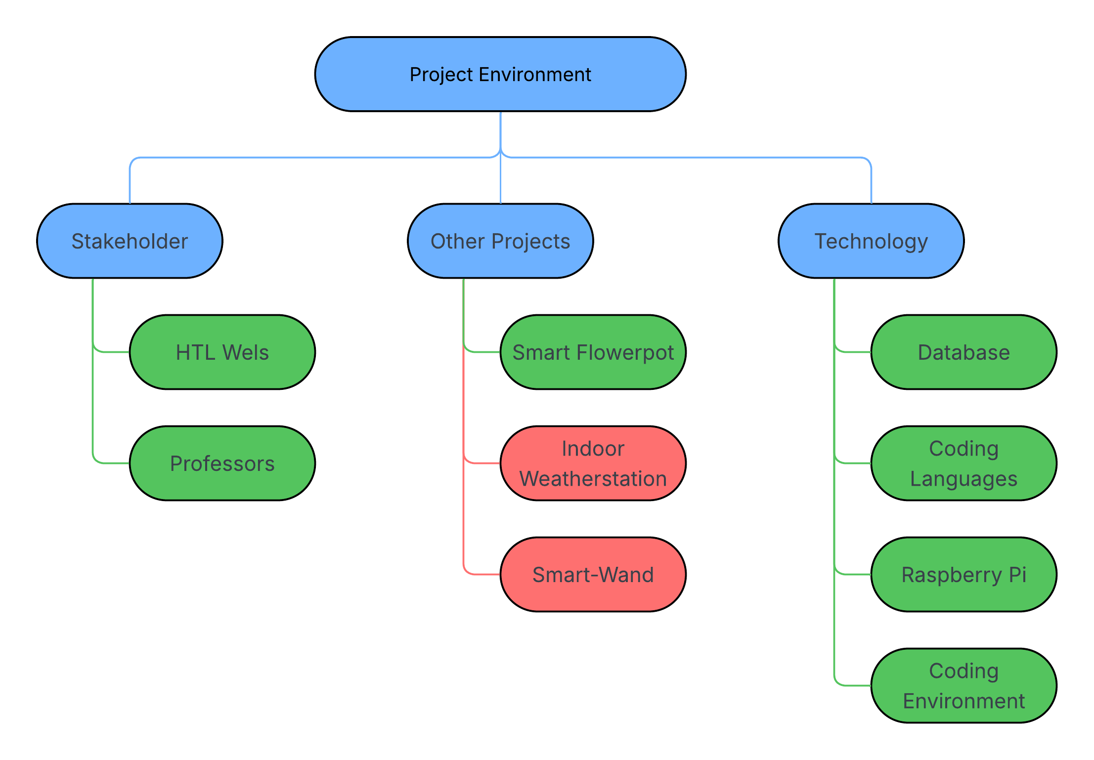
Vorbereitung/Project Handbook/Flowchart.png
