MiKumBa21/Wetterstation/Vorbereitung/Time Planning/Untitled.png

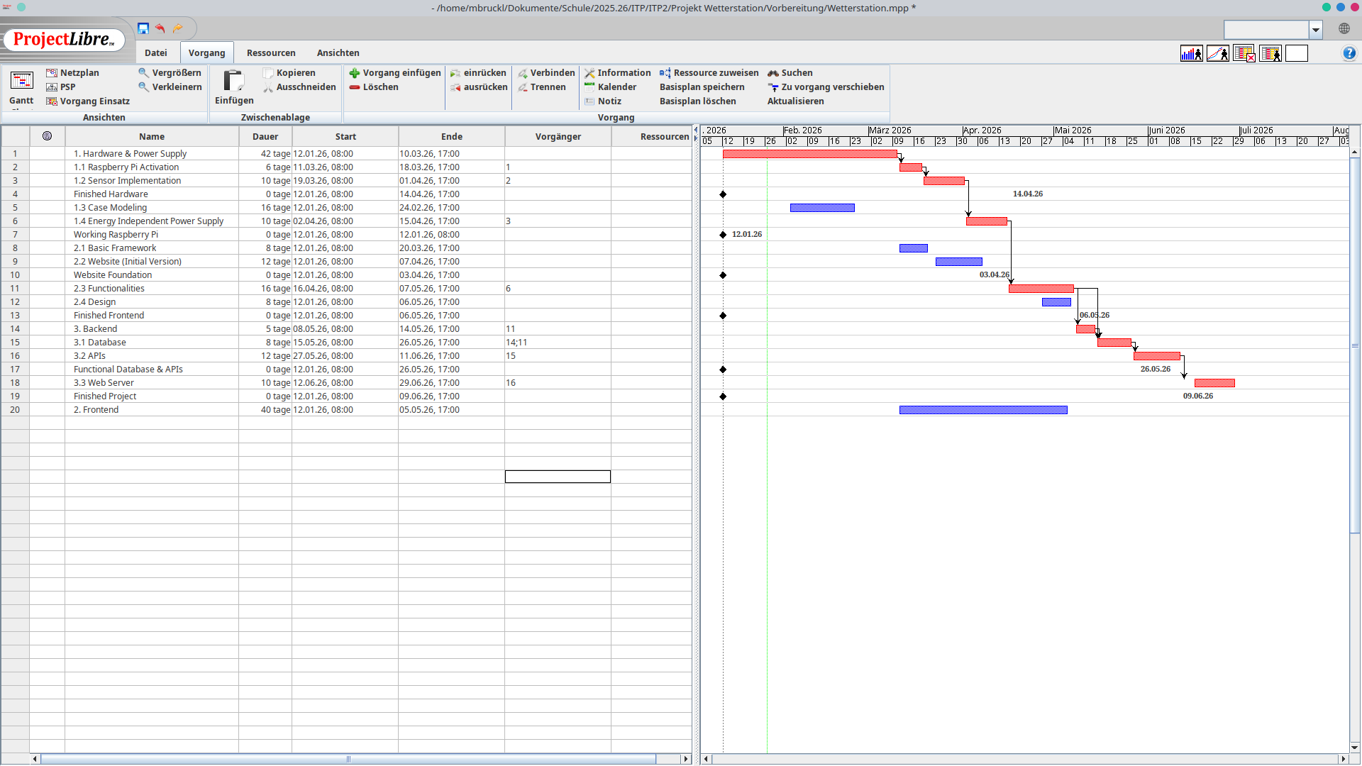
Vorbereitung/Time Planning/Untitled.png
