MiKumBa21/Wetterstation/Vorbereitung/Brainstorming/Materialliste.docx

# Materialliste

# Elektronisches

- Raspberry Pi 0 2W
  - https://www.raspberrypi.com/products/raspberry-pi-zero-2-w
- BME280
  - https://www.reichelt.at/at/de/shop/produkt/entwicklerboards_-_temperatur-_und_drucksensor_bmp280-266034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
  - Humidity
  - Luftdruck
- DHT22
  - JOY-IT Entwicklerboards - Temperatur- & Feuchtigkeitssensor DHT22 | Sensoren & Module günstig kaufen | reichelt elektronik (https://www.reichelt.at/at/de/shop/produkt/entwicklerboards_-_temperatur-_feuchtigkeitssensor_dht22-266104)
  - Luftfeuchtigkeit
  - Temeratur
- Anemometers Wind Speed Monitoring Sensor
  - https://www.fruugo.at/30m-s-polycarbon-wind-geschwindigkeit-richtung-sensor-wetterstation-outdoor-3-cup-anemometer-sensor-outpu/p-246429372-531246758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
  - Luftgeschwindigkeitsmesser
- VEML6075
  - https://www.berrybase.at/sparkfun-qwiic-uv-licht-sensor-breakout-veml6075
  - UV-Sensor
- Steckboard
- Verbindungskabel
- Solar Panel
  - USB / DC / Solar Lithium Ion/Polymer charger [Rev C] : ID 390 : Adafruit Industries, Unique & fun DIY electronics and kits (https://www.adafruit.com/product/390)
  - Lithium Ion Polymer Battery - 3.7v 1200mAh : ID 258 : Adafruit Industries, Unique & fun DIY electronics and kits (https://www.adafruit.com/product/258)
  - 5V 5W Solar Panel - ETFE [Voltaic P105] : ID 5367 : Adafruit Industries, Unique & fun DIY electronics and kits (https://www.adafruit.com/product/5367)
  - Male DC Power adapter - 2.1mm plug to screw terminal block : ID 369 : Adafruit Industries, Unique & fun DIY electronics and kits (https://www.adafruit.com/product/369)
  - 10K Precision Epoxy Thermistor [3950 NTC] : ID 372 : Adafruit Industries, Unique & fun DIY electronics and kits (https://www.adafruit.com/product/372)
  - Um eine Konstante Energieversorgung zu gewährleisten bzw. um es mobil zu machen.
  - Mit diesem Solarpanel/Akku kann die Wetterstation um die 24h ohne neue Energie aushalten bzw. mit 5-6h Sonneneinstrahlung am Tag durchgängig laufen.

# Gehäuse

- PETG-Filament Orange
  - https://amzn.eu/d/fqtccdN
  - Um das Gehäuse zu drucken.
- Lüfter 2x
  - https://www.reichelt.at/at/de/shop/produkt/raspberry_pi_-_luefter_30x30x10_mm_fuer_nespi_und_snespi-gehaeuse-211466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
  - Da wenn man die Sensoren im Gehäuse hat nehmen sie die Werte aus der abgestandenen Luft im Gehäuse auf, anstatt die die allgemein gemessen werden soll.
