MiKumBa21/Wetterstation/3D Modelle/Aerometer_Mount (1) 1.stl

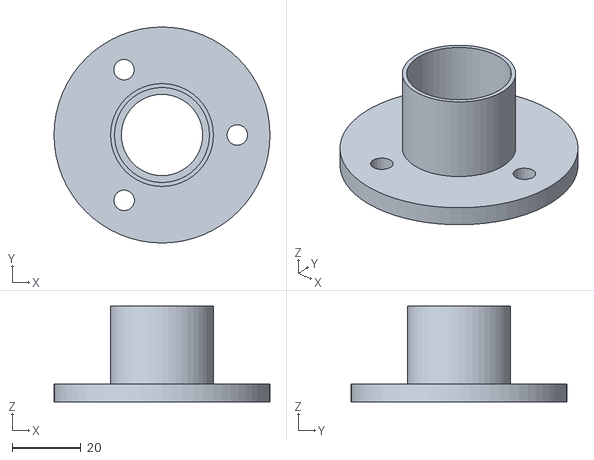
[picture p33: CAD file, 2026-06-12]
3D Modelle/Aerometer_Mount (1) 1.stl
63.0 x 63.0 x 28.0
