MiKumBa21/Wetterstation/3D Modelle/dht22_hülle (3).stl

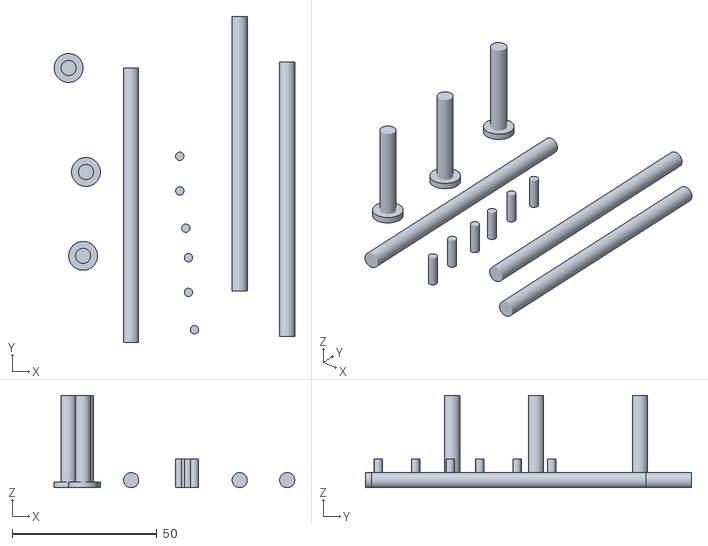
[picture p34: CAD file, 2026-06-12]
3D Modelle/dht22_hülle (3).stl
83.2 x 112.8 x 32.0
