MiKumBa21/Wetterstation/3D Modelle/DHT22_mount (1).stl

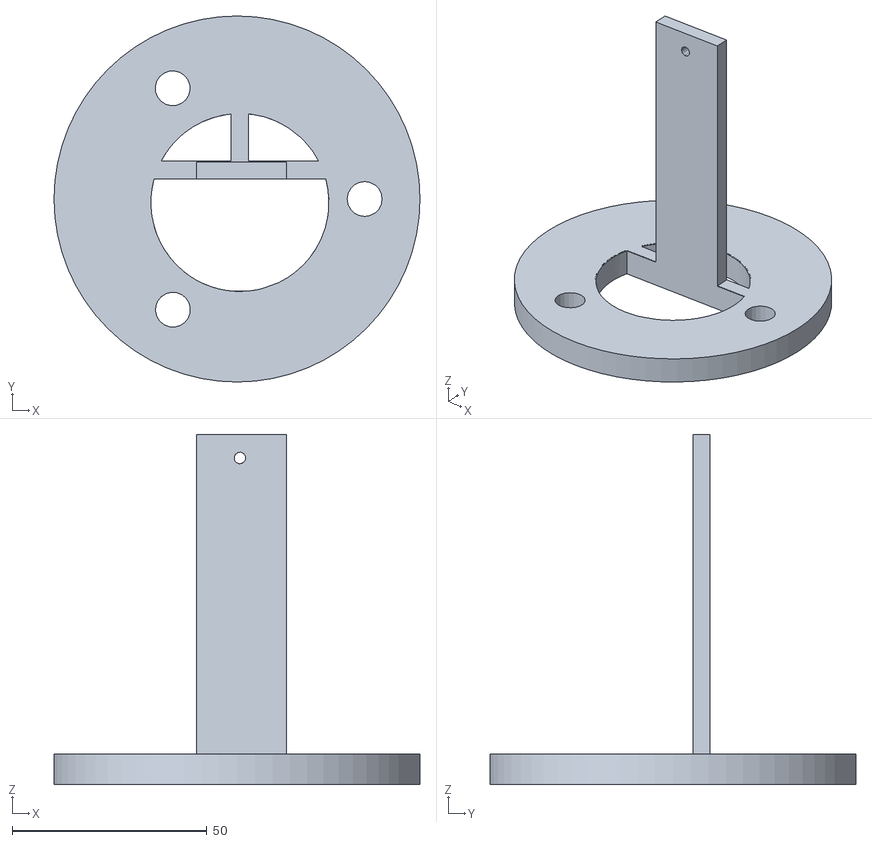
[picture p35: CAD file, 2026-06-12]
3D Modelle/DHT22_mount (1).stl
94.0 x 94.0 x 90.0
