MiKumBa21/Wetterstation/3D Modelle/Sensor_Case_Socket (4).stl

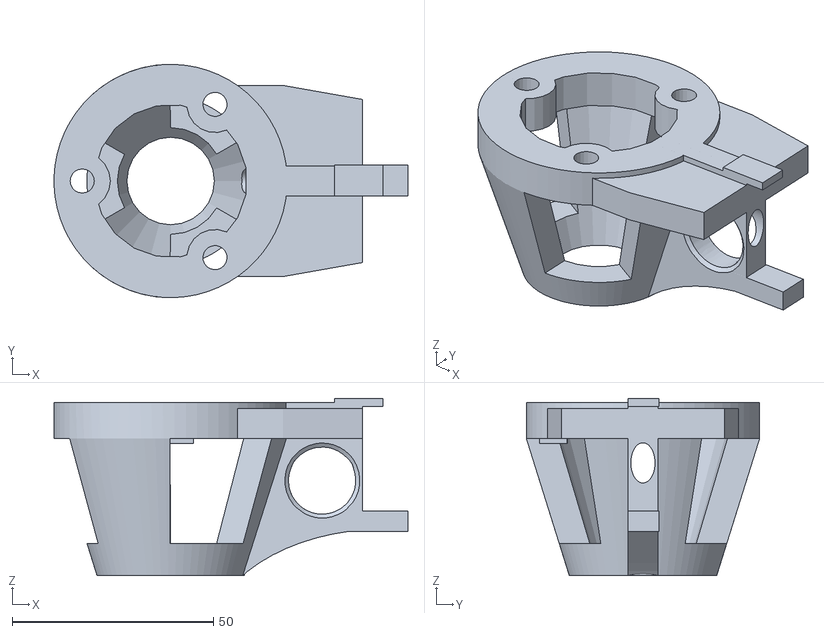
[picture p36: CAD file, 2026-06-12]
3D Modelle/Sensor_Case_Socket (4).stl
88.0 x 58.0 x 44.0
