MiKumBa21/Wetterstation/3D Modelle/dht22_deckel (2).stl

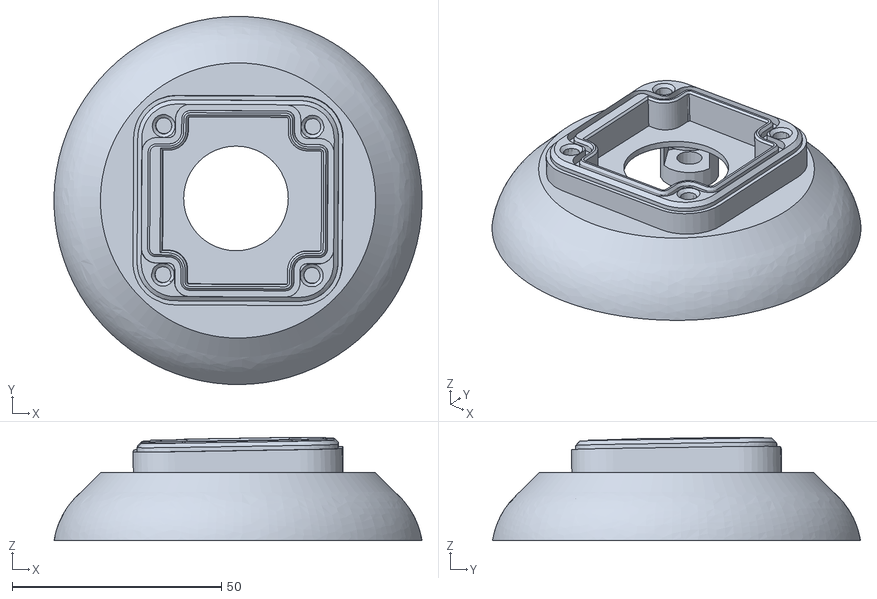
[picture p37: CAD file, 2026-06-12]
3D Modelle/dht22_deckel (2).stl
88.0 x 88.0 x 24.7
