MiKumBa21/Wetterstation/3D Modelle/Velm7700_deckel 2.stl

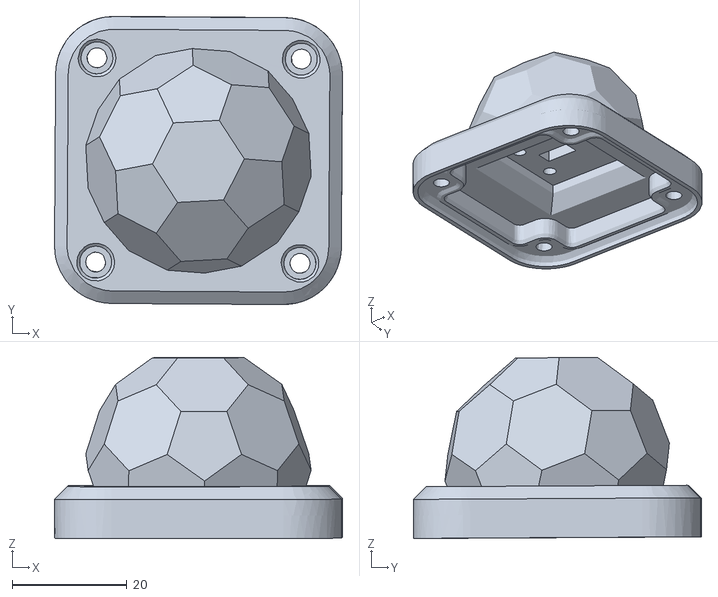
[picture p38: CAD file, 2026-06-12]
3D Modelle/Velm7700_deckel 2.stl
50.2 x 50.2 x 31.6
