MiKumBa21/Wetterstation/3D Modelle/Dach_wetterstation (3).stl

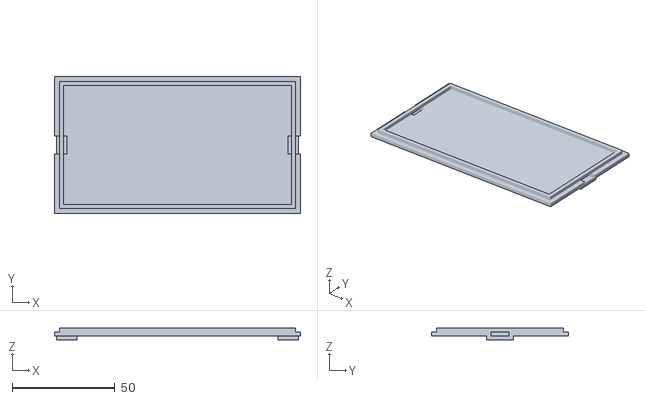
[picture p39: CAD file, 2026-06-12]
3D Modelle/Dach_wetterstation (3).stl
120.0 x 67.0 x 6.00
