MiKumBa21/Wetterstation/(commit log)

2025-11-06 Materialliste hinzugefügt
2025-11-07 Materialliste update
2025-11-07 änderung Material
2025-11-07 Material update
2025-11-07 material fertig
2025-11-07 materialien fertig
2026-04-27 neues Design mit Burgermenü und Farbverlauf
2026-05-06 Wieder zuruckghoit die schene website (mit ordnerstruktur (hoffentlich))
2026-06-12 added 3d models
    [Aerometer_Mount (1) 1.stl, DHT22_mount (1).stl, Dach_wetterstation (3).stl, Sensor_Case_Socket (4).stl, Velm7700_deckel 2.stl, dht22_deckel (2).stl, dht22_hülle (3).stl]
